szymon-piorun-eng/Programmable-Power-Supply/data/Hardware/Programmable_Power_Supply/Programmable_Power_Supply.kicad_pcb

## KiCad design data/Hardware/Programmable_Power_Supply/Programmable_Power_Supply.kicad_pcb (2026-04-16)

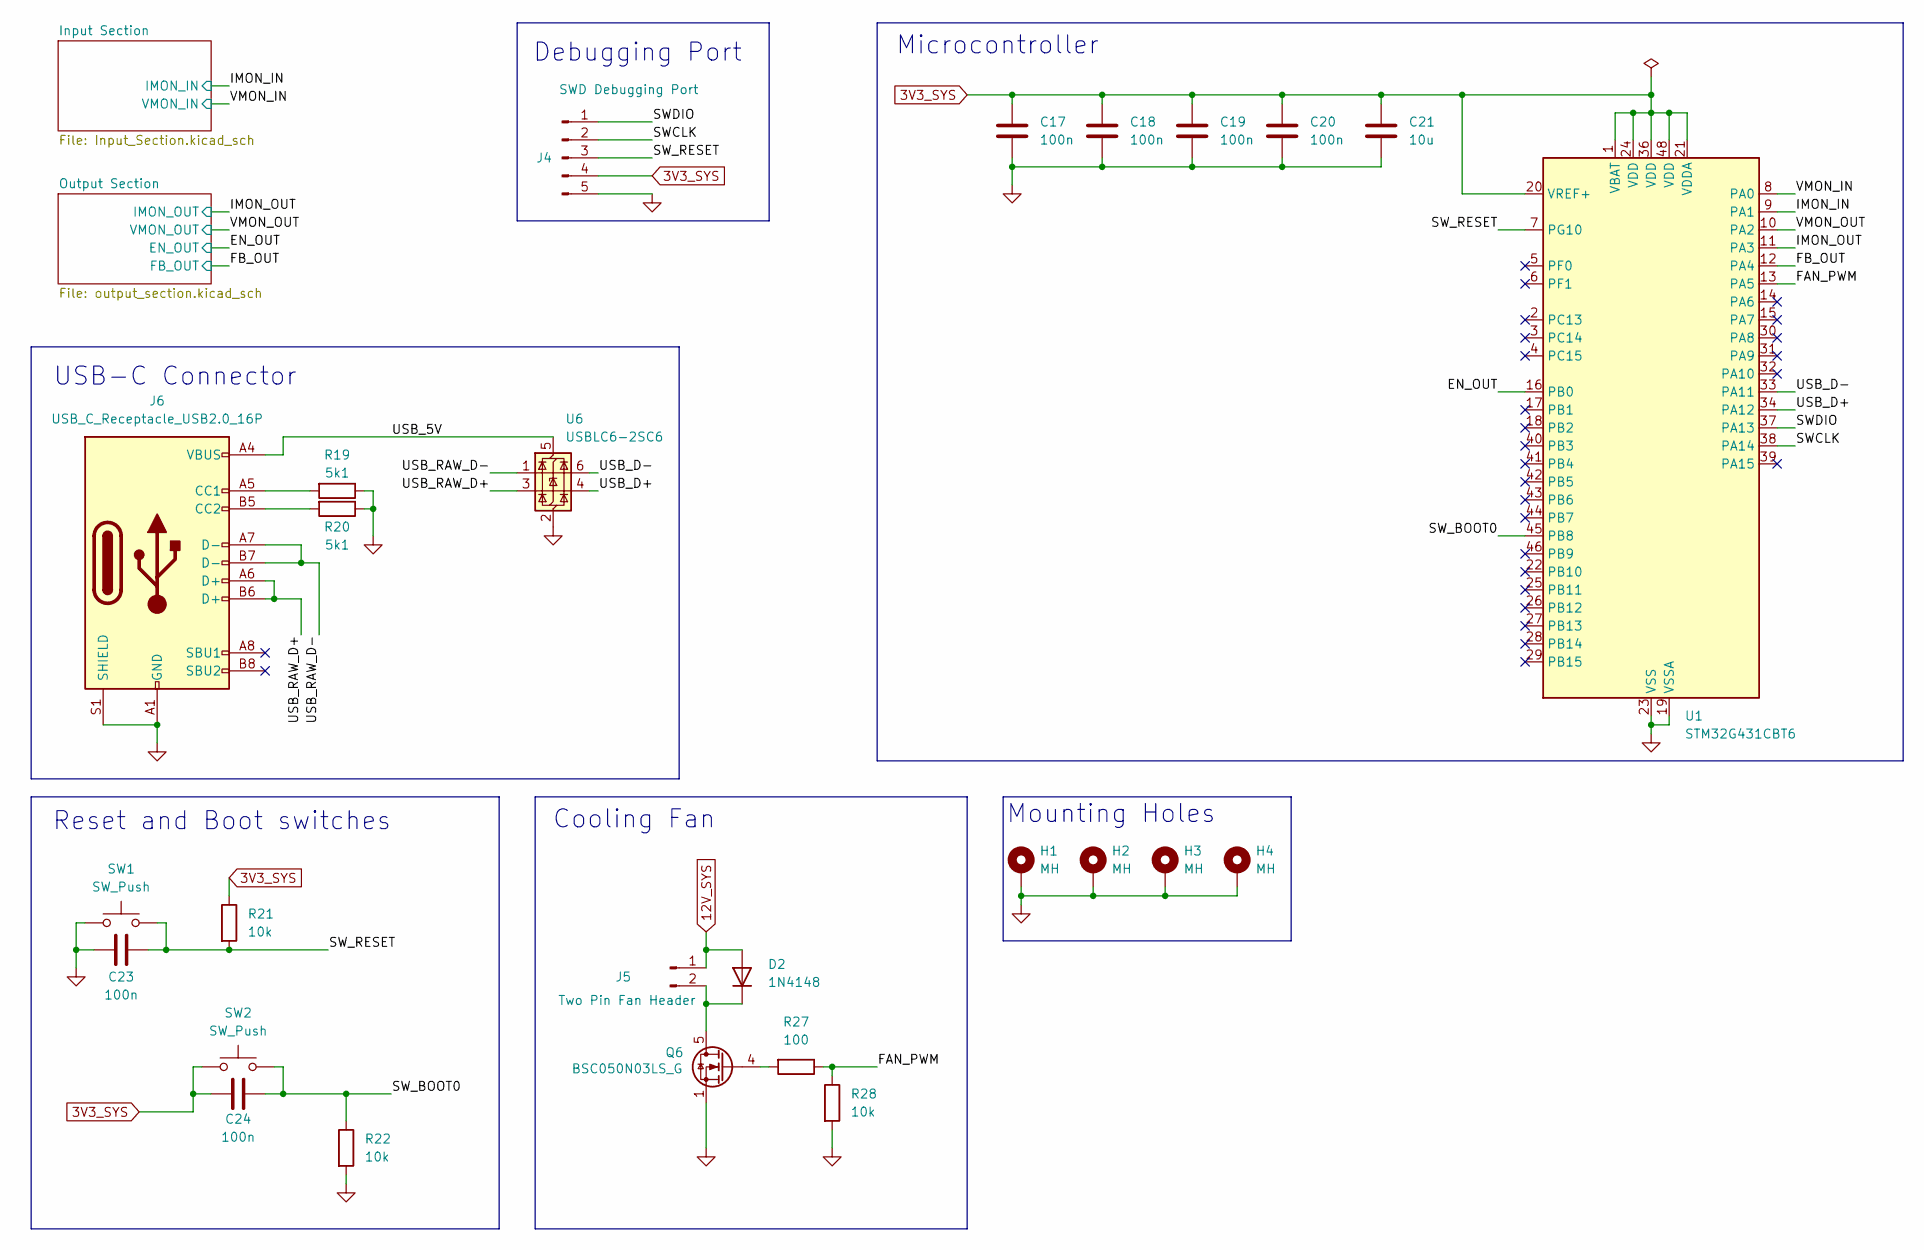
[picture p1: schematic Programmable_Power_Supply.kicad_sch, Programmable Power Supply]

Parts:
C17, C18, C19, C20, C23, C24: 100n; C_0201_0603Metric_Pad0.64x0.40mm_HandSolder; Mouser MLASG063SB5104KFNA01
C21: 10u; C_1206_3216Metric_Pad1.33x1.80mm_HandSolder; Mouser GXT31CR6YA106KE01L
D2: 1N4148; SOD323; Mouser 1N4148WS-HE3_A-18
H1, H2, H3, H4: MH; MountingHole_3.2mm_M3_ISO7380_Pad_TopBottom
J4: SWD Debugging Port; PinHeader_1x05_P2.54mm_Vertical
J5: Two Pin Fan Header; Molex_KK-254_AE-6410-02A_1x02_P2.54mm_Vertical; Mouser 22-23-2021
J6: USB_C_Receptacle_USB2.0_16P; USB_C_Receptacle_GCT_USB4105-xx-A_16P_TopMnt_Horizontal; Mouser USB4930-00-A
Q6: BSC050N03LS_G; Infineon_PG-TDSON-8_6.15x5.15mm
R19, R20: 5k1; R_0603_1608Metric_Pad0.98x0.95mm_HandSolder; Mouser CR0603-FX-5101ELF
R21, R22, R28: 10k; R_0603_1608Metric_Pad0.98x0.95mm_HandSolder; Mouser RCA060310K0FKEC
R27: 100; R_0603_1608Metric_Pad0.98x0.95mm_HandSolder; Mouser RT0603BRB07100RL
SW1, SW2: SW_Push; TS046650BK100SMTTR; Mouser TS04-66-50-BK-100-SMT-TR
U1: STM32G431CBT6; LQFP-48_7x7mm_P0.5mm; Mouser STM32G431CBT6
U6: USBLC6-2SC6; SOT-23-6; Mouser USBLC6-2SC6

Connections:
3V3_SYS: C17.1, C18.1, C19.1, C20.1, C21.1, C24.2, J4.4, R21.1, SW2.1, U1.1 (VBAT), U1.20 (VREF+), U1.21 (VDDA), U1.24 (VDD), U1.36 (VDD), U1.48 (VDD); also elsewhere on the board
12V_SYS: D2.2 (A), J5.1; also elsewhere on the board
/EN_OUT: U1.16 (PB0); also elsewhere on the board
/FAN_PWM: R27.1, R28.1, U1.13 (PA5)
/FB_OUT: U1.12 (PA4); also elsewhere on the board
/IMON_IN: U1.9 (PA1); also elsewhere on the board
/IMON_OUT: U1.11 (PA3); also elsewhere on the board
/SWCLK: J4.2, U1.38 (PA14)
/SWDIO: J4.1, U1.37 (PA13)
/SW_BOOT0: C24.1, R22.1, SW2.2, U1.45 (PB8)
/SW_RESET: C23.2, J4.3, R21.2, SW1.2, U1.7 (PG10)
/USB_5V: J6.A4 (VBUS), J6.A9 (VBUS), J6.B4 (VBUS), J6.B9 (VBUS), U6.5 (VBUS)
/USB_D+: U1.34 (PA12), U6.4 (I/O2)
/USB_D-: U1.33 (PA11), U6.6 (I/O1)
/USB_RAW_D+: J6.A6 (D+), J6.B6 (D+), U6.3 (I/O2)
/USB_RAW_D-: J6.A7 (D-), J6.B7 (D-), U6.1 (I/O1)
/VMON_IN: U1.8 (PA0); also elsewhere on the board
/VMON_OUT: U1.10 (PA2); also elsewhere on the board
GND: C17.2, C18.2, C19.2, C20.2, C21.2, C23.1, H1.1, H2.1, H3.1, H4.1, J4.5, J6.A1 (GND), J6.A12 (GND), J6.B1 (GND), J6.B12 (GND), J6.S1 (SHIELD), Q6.1 (S), Q6.2 (S), Q6.3 (S), R19.1, R20.1, R22.2, R28.2, SW1.1, U1.19 (VSSA), U1.23 (VSS), U1.35 (VSS), U1.47 (VSS), U6.2 (GND); also elsewhere on the board
unnamed: D2.1 (K), J5.2, Q6.5 (D)
unnamed: J6.A5 (CC1), R19.2
unnamed: J6.B5 (CC2), R20.2
unnamed: Q6.4 (G), R27.2

Notes on the sheet:
Microcontroller
Mounting Holes
Debugging Port
USB-C Connector
Reset and Boot switches
Cooling Fan

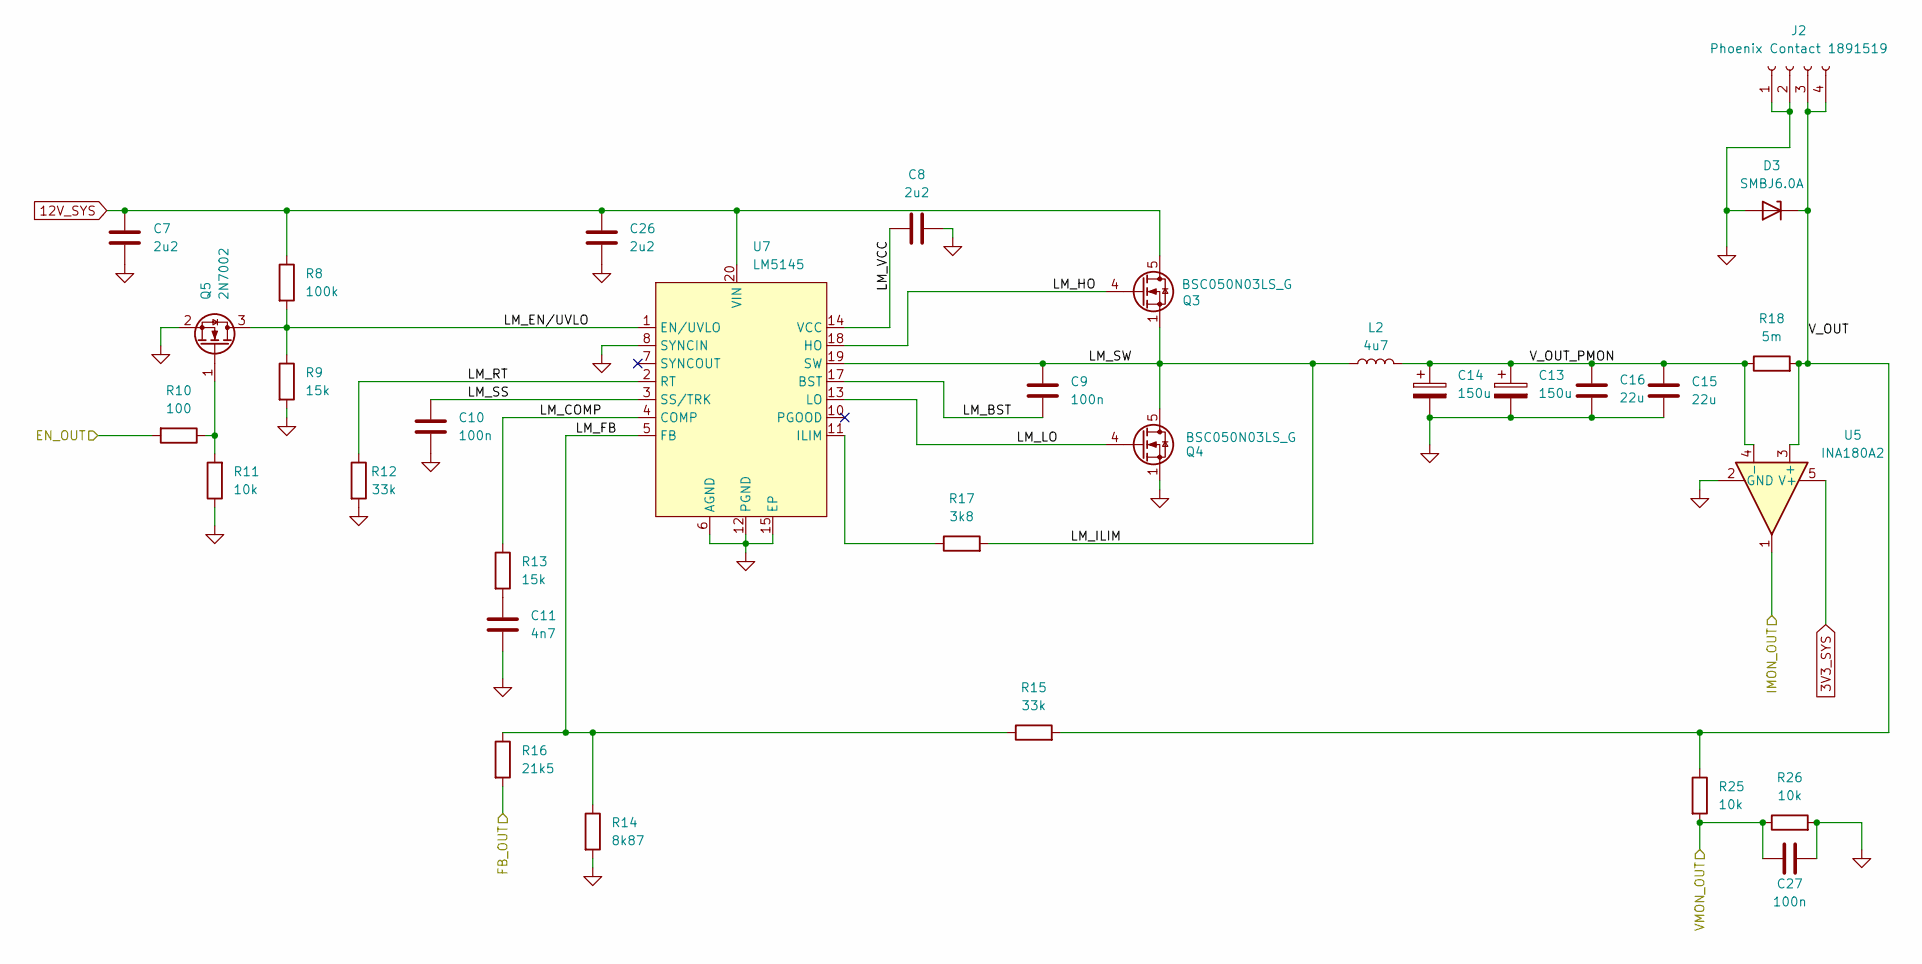
[picture p2: schematic output_section.kicad_sch, Output Section]

Parts:
C7, C8, C26: 2u2; C_1206_3216Metric_Pad1.33x1.80mm_HandSolder; Mouser 885382208016
C9, C10, C27: 100n; C_0201_0603Metric_Pad0.64x0.40mm_HandSolder; Mouser MLASG063SB5104KFNA01
C11: 4n7; C_0805_2012Metric_Pad1.18x1.45mm_HandSolder; Mouser KAM21BR72A472KT
C13, C14: 150u; CAPPM7343X310N; Mouser 593D157X0010D2TE3
C15, C16: 22u; C_1206_3216Metric_Pad1.33x1.80mm_HandSolder; Mouser GRM31CC71C226ME11K
D3: SMBJ6.0A; D_SMB_Handsoldering; Mouser SMBJ6.0A
J2: Phoenix Contact 1891519; 2 pin power connector; Mouser 1891519
L2: 4u7; L_Wuerth_HCI-1365; Mouser 7443551470
Q3, Q4: BSC050N03LS_G; Infineon_PG-TDSON-8_6.15x5.15mm
Q5: 2N7002; SOT-23; Mouser 2N7002
R8: 100k; R_0603_1608Metric_Pad0.98x0.95mm_HandSolder; Mouser RCA0603100KFKEC
R9, R13: 15k; R_0603_1608Metric_Pad0.98x0.95mm_HandSolder; Mouser MCT06030C1502FPW00
R10: 100; R_0603_1608Metric_Pad0.98x0.95mm_HandSolder; Mouser RT0603BRB07100RL
R11, R25, R26: 10k; R_0603_1608Metric_Pad0.98x0.95mm_HandSolder; Mouser RCA060310K0FKEC
R12, R15: 33k; R_0603_1608Metric_Pad0.98x0.95mm_HandSolder; Mouser RCA060333K0FKEA
R14: 8k87; R_0603_1608Metric_Pad0.98x0.95mm_HandSolder; Mouser 560112116137
R16: 21k5; R_0603_1608Metric_Pad0.98x0.95mm_HandSolder; Mouser CRT0603-FZ-2152ELF
R17: 3k8; R_0603_1608Metric_Pad0.98x0.95mm_HandSolder; Mouser RN73R1JTTD3282F100
R18: 5m; R_2512_6332Metric_Pad1.40x3.35mm_HandSolder; Mouser WSLP25125L000FEA
U5: INA180A2; SOT-23-5; Mouser INA180A2IDBVR
U7: LM5145; RGY0020B; Mouser LM5145RGYR

Connections:
3V3_SYS: U5.5 (V+); also elsewhere on the board
12V_SYS: C7.2, C26.2, Q3.5 (D), R8.1, U7.20 (VIN); also elsewhere on the board
/EN_OUT: R10.2; also elsewhere on the board
/FB_OUT: R16.2; also elsewhere on the board
/IMON_OUT: U5.1; also elsewhere on the board
/Output Section/LM_BST: C9.2, U7.17 (BST)
/Output Section/LM_COMP: R13.1, U7.4 (COMP)
/Output Section/LM_EN/UVLO: Q5.3 (D), R8.2, R9.1, U7.1 (EN/UVLO)
/Output Section/LM_FB: R14.1, R15.1, R16.1, U7.5 (FB)
/Output Section/LM_HO: Q3.4 (G), U7.18 (HO)
/Output Section/LM_ILIM: C9.1, L2.1, Q3.1 (S), Q3.2 (S), Q3.3 (S), Q4.5 (D), R17.2, U7.19 (SW)
/Output Section/LM_LO: Q4.4 (G), U7.13 (LO)
/Output Section/LM_RT: R12.1, U7.2 (RT)
/Output Section/LM_SS: C10.1, U7.3 (SS/TRK)
/Output Section/LM_VCC: C8.1, U7.14 (VCC)
/Output Section/V_OUT: D3.1 (K), J2.3, J2.4, R15.2, R18.2, R25.1, U5.3 (+)
/Output Section/V_OUT_PMON: C13.1, C14.1, C15.1, C16.1, L2.2, R18.1, U5.4 (-)
/VMON_OUT: C27.1, R25.2, R26.1; also elsewhere on the board
GND: C7.1, C8.2, C10.2, C11.2, C13.2, C14.2, C15.2, C16.2, C26.1, C27.2, D3.2 (A), J2.1, J2.2, Q4.1 (S), Q4.2 (S), Q4.3 (S), Q5.2 (S), R9.2, R11.1, R12.2, R14.2, R26.2, U5.2 (GND), U7.6 (AGND), U7.8 (SYNCIN), U7.12 (PGND), U7.15 (EP), U7.V; also elsewhere on the board
unnamed: C11.1, R13.2
unnamed: Q5.1 (G), R10.1, R11.2
unnamed: R17.1, U7.11 (ILIM)

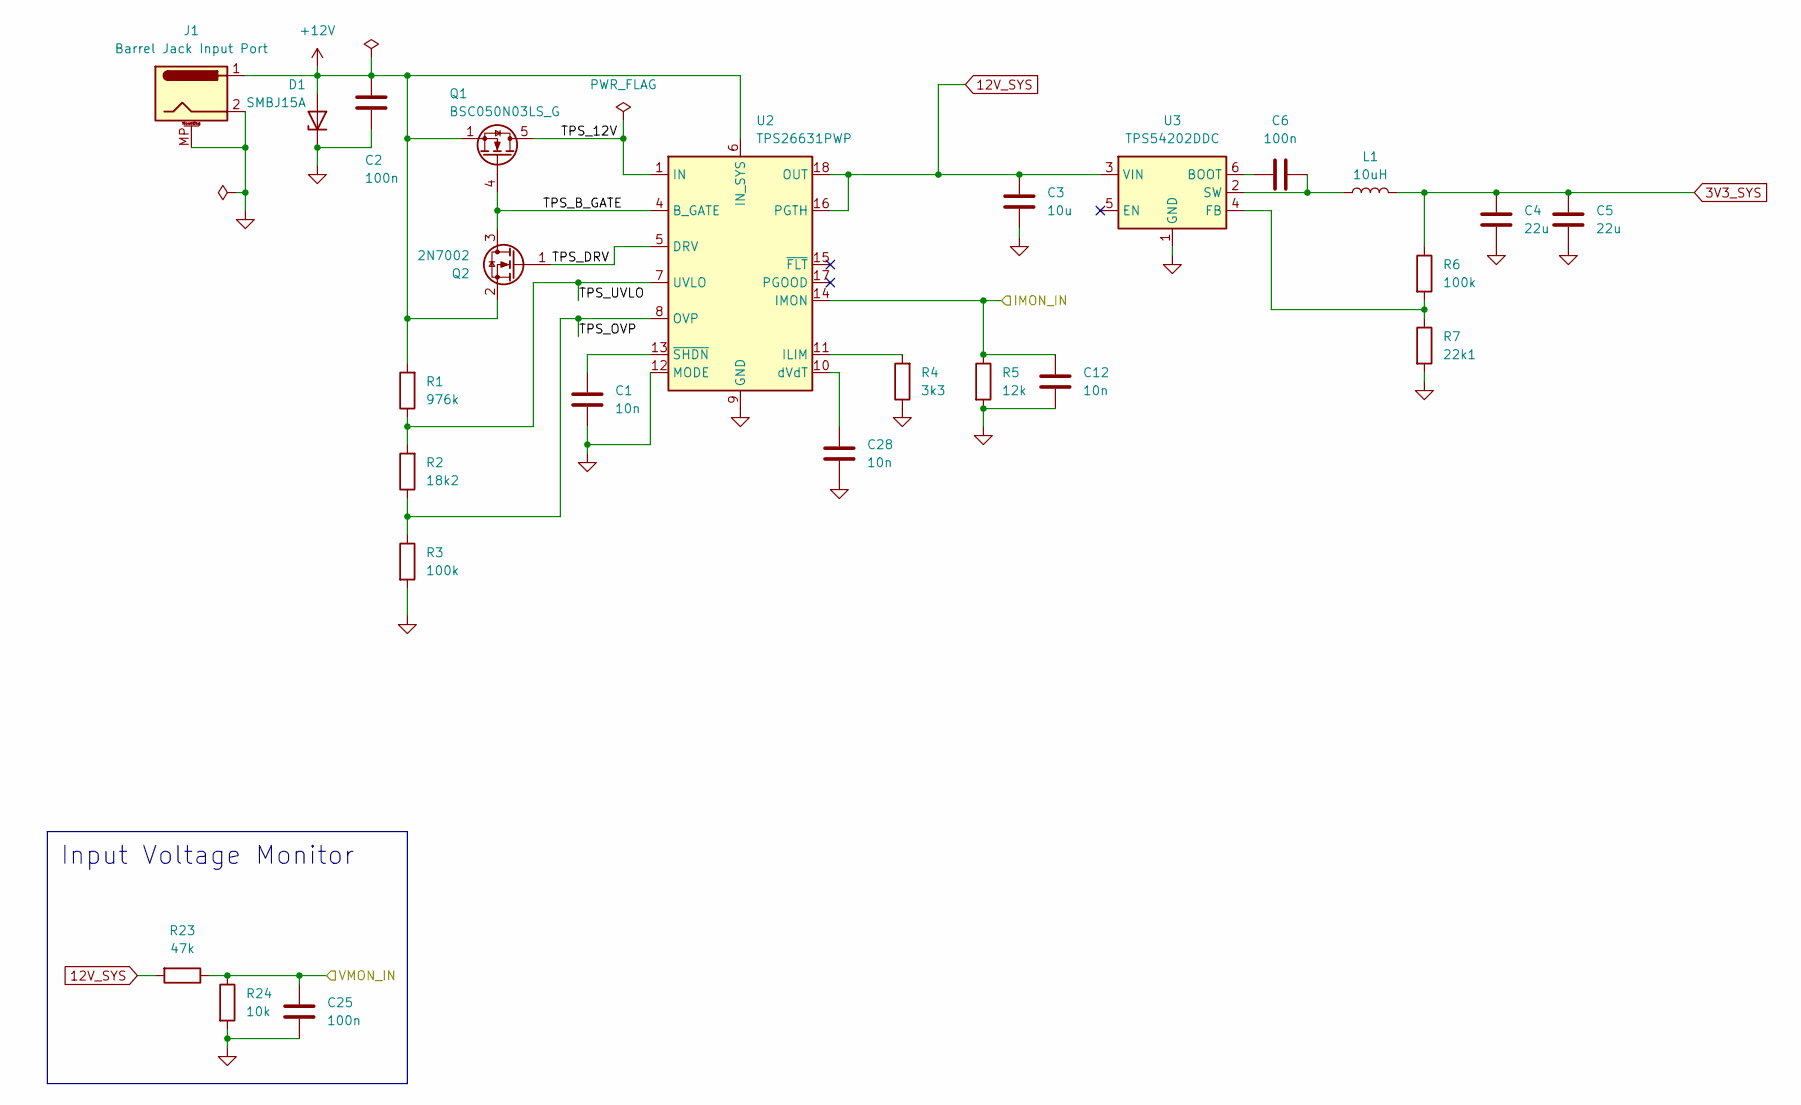
[picture p3: schematic Input_Section.kicad_sch, Input Section]

Parts:
C1, C12, C28: 10n; C_0201_0603Metric_Pad0.64x0.40mm_HandSolder; Mouser MLASU063SB5103KFNA01
C2, C6, C25: 100n; C_0201_0603Metric_Pad0.64x0.40mm_HandSolder; Mouser MLASG063SB5104KFNA01
C3: 10u; C_1206_3216Metric_Pad1.33x1.80mm_HandSolder; Mouser GXT31CR6YA106KE01L
C4, C5: 22u; C_1206_3216Metric_Pad1.33x1.80mm_HandSolder; Mouser GRM31CC71C226ME11K
D1: SMBJ15A; D_SMB_Handsoldering; Mouser SMBJ15A
J1: Barrel Jack Input Port; BarrelJack_CUI_PJ-063AH_Horizontal; Mouser PJ-063AH
L1: 10uH; SRP6540; Mouser SRP6540-100M
Q1: BSC050N03LS_G; Infineon_PG-TDSON-8_6.15x5.15mm
Q2: 2N7002; SOT-23; Mouser 2N7002
R1: 976k; R_0603_1608Metric_Pad0.98x0.95mm_HandSolder; Mouser CRCW0603976KFKTA
R2: 18k2; R_0603_1608Metric_Pad0.98x0.95mm_HandSolder; Mouser AF0603FR-0718K2L
R3, R6: 100k; R_0603_1608Metric_Pad0.98x0.95mm_HandSolder; Mouser RCA0603100KFKEC
R4: 3k3; R_0603_1608Metric_Pad0.98x0.95mm_HandSolder; Mouser CR0603-FX-3301ELF
R5: 12k; R_0603_1608Metric_Pad0.98x0.95mm_HandSolder; Mouser 560112116040
R7: 22k1; R_0603_1608Metric_Pad0.98x0.95mm_HandSolder; Mouser CRCW060322K1FKEBC
R23: 47k; R_0603_1608Metric_Pad0.98x0.95mm_HandSolder; Mouser CRCW060347K0FKECC
R24: 10k; R_0603_1608Metric_Pad0.98x0.95mm_HandSolder; Mouser RCA060310K0FKEC
U2: TPS26631PWP; HTSSOP-20-1EP_4.4x6.5mm_P0.65mm_EP3.4x6.5mm_Mask2.96x2.96mm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; Mouser TPS26633PWPR
U3: TPS54202DDC; SOT-23-6; Mouser TPS542025DDCR

Connections:
3V3_SYS: C4.1, C5.1, L1.2, R6.1; also elsewhere on the board
12V_SYS: C3.1, R23.2, U2.16 (PGTH), U2.18 (OUT), U2.19 (OUT), U2.20 (OUT), U3.3 (VIN); also elsewhere on the board
+12V: C2.1, D1.2 (A), J1.1, Q1.1 (S), Q1.2 (S), Q1.3 (S), Q2.2 (S), R1.2, U2.6 (IN_SYS)
/IMON_IN: C12.1, R5.1, U2.14 (IMON); also elsewhere on the board
/Input Section/TPS_12V: Q1.5 (D), U2.1 (IN), U2.2 (IN), U2.3 (IN)
/Input Section/TPS_B_GATE: Q1.4 (G), Q2.3 (D), U2.4 (B_GATE)
/Input Section/TPS_DRV: Q2.1 (G), U2.5 (DRV)
/Input Section/TPS_OVP: R2.1, R3.1, U2.8 (OVP)
/Input Section/TPS_UVLO: R1.1, R2.2, U2.7 (UVLO)
/VMON_IN: C25.1, R23.1, R24.1; also elsewhere on the board
GND: C1.2, C2.2, C3.2, C4.2, C5.2, C12.2, C25.2, C28.2, D1.1 (K), J1.2, J1.MP (MountPin), R3.2, R4.1, R5.2, R7.2, R24.2, U2.9 (GND), U2.12 (MODE), U2.21 (GND), U3.1 (GND); also elsewhere on the board
unnamed: R4.2, U2.11 (ILIM)
unnamed: C28.1, U2.10 (dVdT)
unnamed: C1.1, U2.13 (~SHDN)
unnamed: C6.1, U3.6 (BOOT)
unnamed: R6.2, R7.1, U3.4 (FB)
unnamed: C6.2, L1.1, U3.2 (SW)

Notes on the sheet:
Input Voltage Monitor

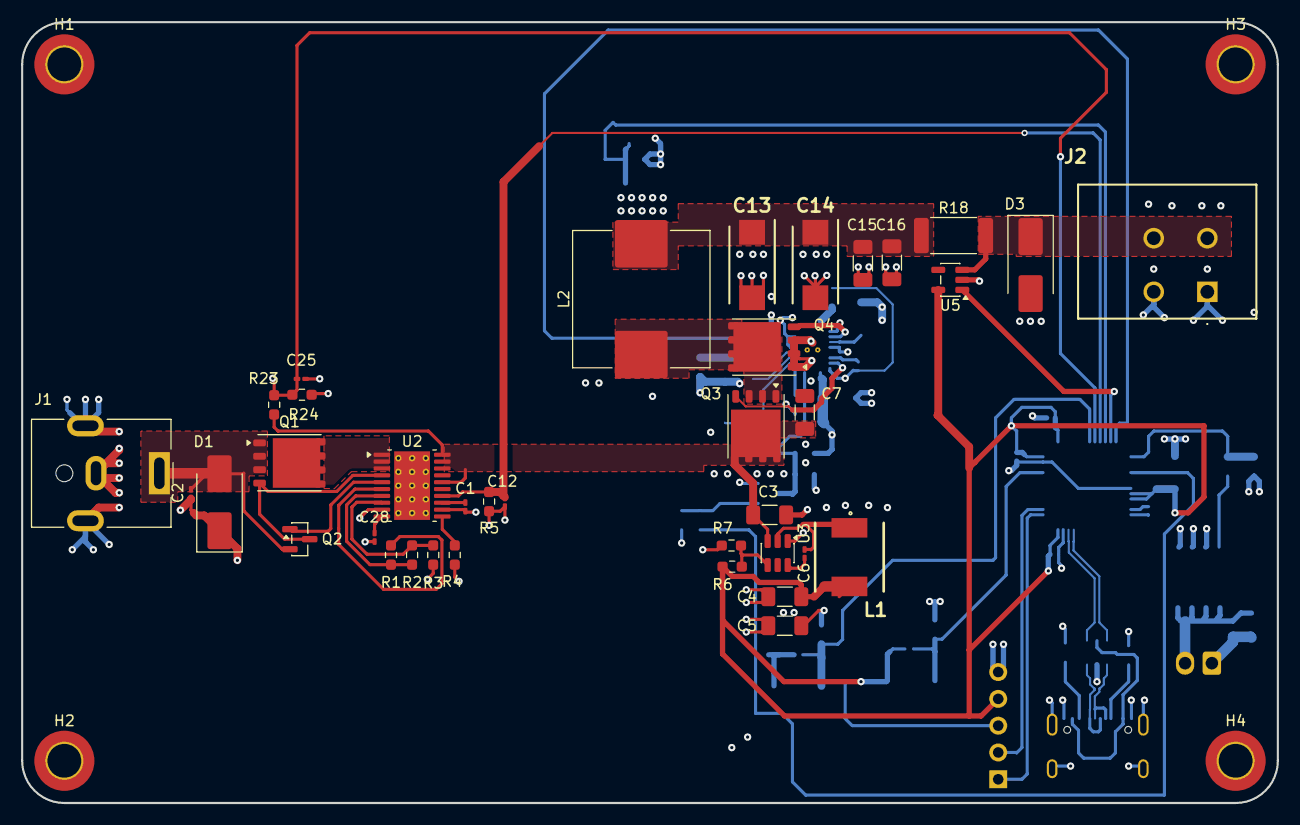
[picture p4: board Programmable_Power_Supply.kicad_pcb from above]

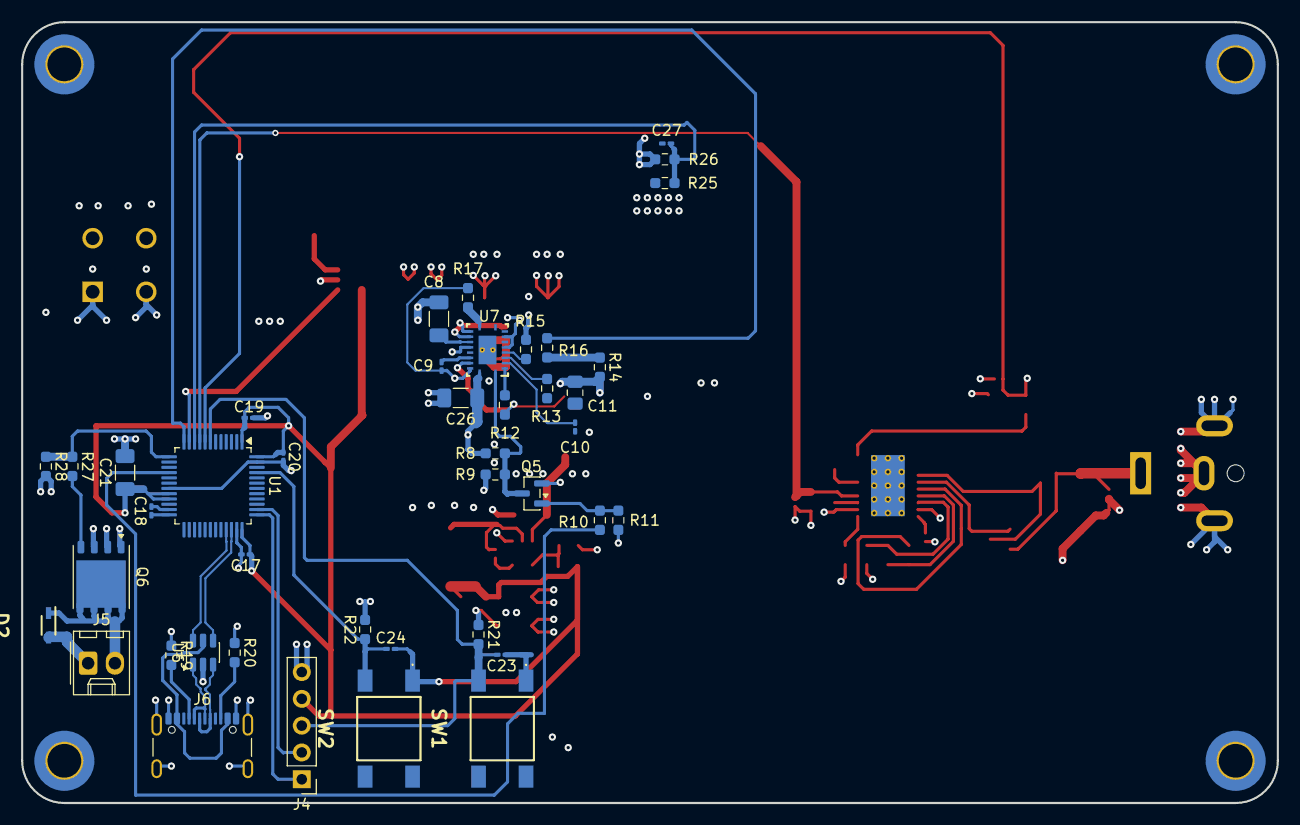
[picture p5: board Programmable_Power_Supply.kicad_pcb from below]

Board: 4 copper layers, 119.0 x 74.0 mm, 83 parts (42 on the bottom side), 50 nets.
