szymon-piorun-eng/Programmable-Power-Supply/(commit log)

2026-03-24 docs: Modifying linters for current project.
2026-04-08 docs: Editing gitignore for KiCad temporary files
2026-04-08 docs: Adding initial electrical diagram with input section implemented
    [Input_Section.kicad_sch, Programmable_Power_Supply.kicad_pcb, Programmable_Power_Supply.kicad_sch]
2026-04-08 docs: Updating git ignore to ignore KiCad auto back-ups
2026-04-09 feat: Adding output section to the schematic.
    [Input_Section.kicad_sch, Programmable_Power_Supply.kicad_sch, output_section.kicad_sch]
2026-04-09 feat: First draw of full schematic with all footprints and symbols.
    [Input_Section.kicad_sch, Programmable_Power_Supply.kicad_sch, output_section.kicad_sch]
2026-04-10 feat: Final version of revision A of the schematic with mouser product numbers attached.
    [Input_Section.kicad_sch, Programmable_Power_Supply.kicad_sch, output_section.kicad_sch]
2026-04-16 feat: First full layout of the PCB
    [Input_Section.kicad_sch, Programmable_Power_Supply.kicad_pcb, Programmable_Power_Supply.kicad_sch, output_section.kicad_sch]
2026-04-16 feat: Layout of USB-C port and final beta version of the board.
    [Programmable_Power_Supply.kicad_pcb, Programmable_Power_Supply.kicad_sch]
